NakahiraLab/dokoten/README.md

# どこ点シューズ

中平研2025卒メンバーのプロジェクトです。

## ディレクトリ構成
```
.
├── docs・・・・・・・・・・・・最終発表資料・予稿、その他学会資料など
├── shoes
|   ├── ESP32・・・・・・・・・シューズ内のESP32の制御コード
|   └── hw_model・・・・・・・シューズの設計ファイル(stl)
├── walk_test・・・・・・・・・模擬歩行実験装置を使うためのファイル群
└── README.md・・・・・・・・・このファイル
```
