NakahiraLab/dokoten/shoes/ESP32/README.md

# ESP32 動作コード

- parallelProcess
  - 並列処理コード
  - FreeRTOSを参考に自作したやつ
- simple
  - 単純な順次処理コード。動作確認に。

## 動作環境
| | |
| :-: | --- |
| マイコン | ESP32 |
| IDE | Arduino IDE 1.8.19 |
