NakahiraLab/dokoten/docs/SattoShinzato/presentation.pdf

# 増速歯車機構を用いた足押し発電試作 装置の発電量の評価

情報通信システム工学科 Ic201223 新里察得
指導教員：中平勝也

## 【視覚障害者向け歩行支援シューズ】

# 研究背景

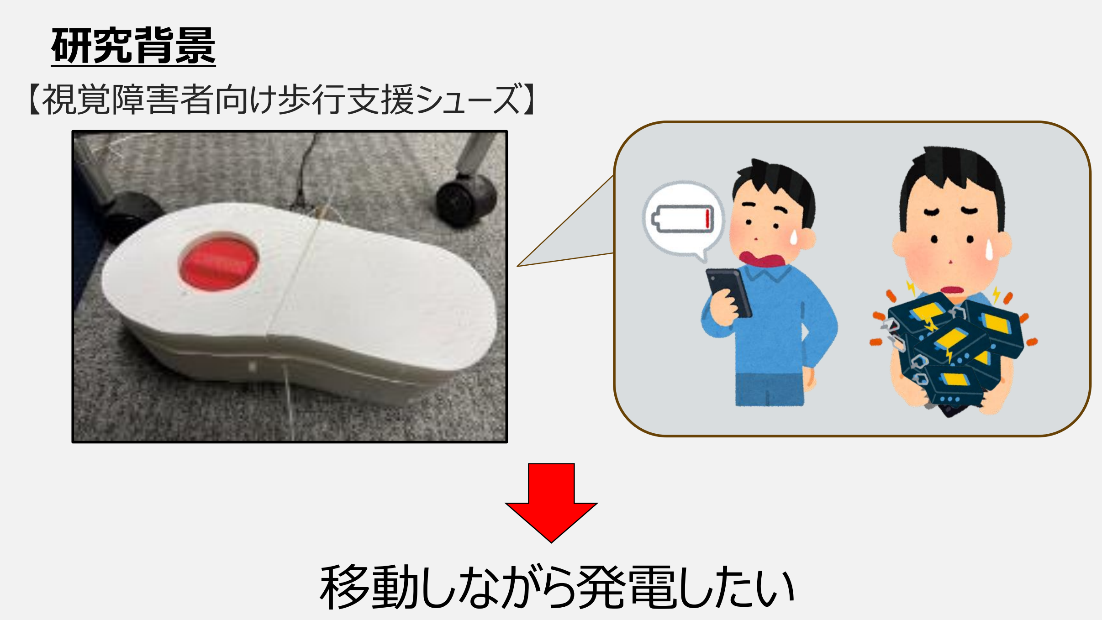
[picture p1: page 2]

# 移動しながら発電したい

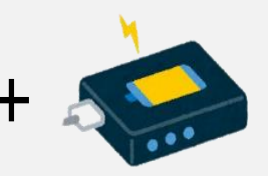
[picture p2: figure]
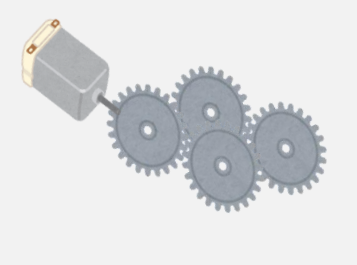
[picture p3: figure]
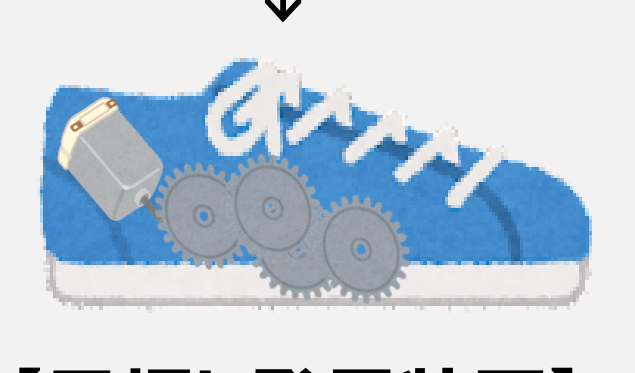
[picture p4: figure]

# 【足押し発電装置】

←

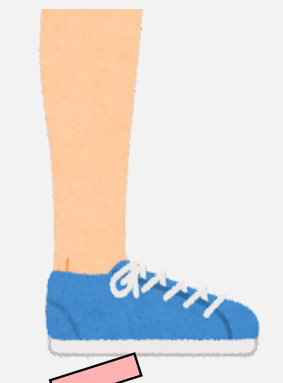
[picture p5: figure]

# 【足踏み機構】 【増速歯車装置】 【モバイルバッテリー】

# 提案する足押し発電装置

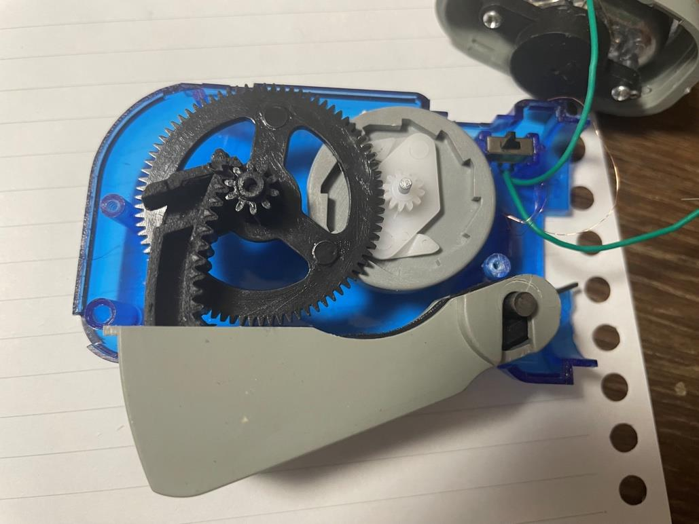
[picture p6: figure]
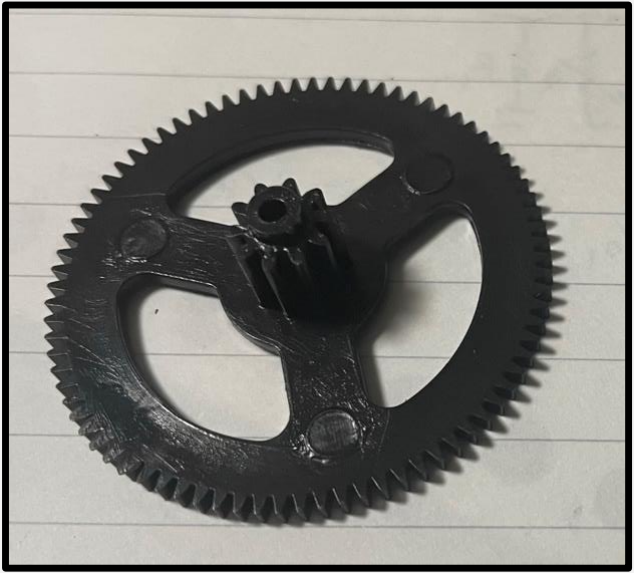
[picture p7: figure]
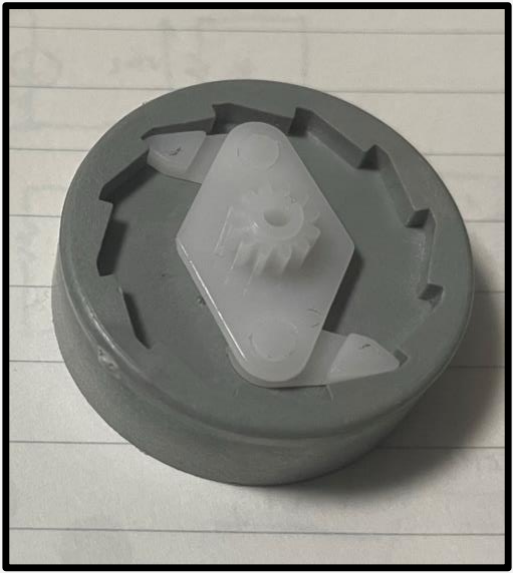
[picture p8: figure]

# 1分間に665回転することができる。

## ・直径[0.8cm] ・歯の数[12]

## 【歯車A】

## 駆動歯車

## 【歯車B】

## 発電用モーター

## ・直径[4cm]

ハンドクランクライト | ・歯の数[84]

# 増速歯車装置の内部構造

７倍

# 目標時間

# 3.8mW × 665 × 60=150Wh=150,000mWh

# 適用可能

## 【10,000mAh×3.7v】

一般的なバッテリー容量 | 消費電力
| 5,000mWh + 15,000mWh
÷ 【マイコン】 | 【スマホ】

5

# 足押し発電装置の適用判断

# 予測時間

# =1時間50分

# モバイルバッテリーを約15分で満充電

# 従来のウェアラブル発電装置

# 移動しながら発電する方法として、

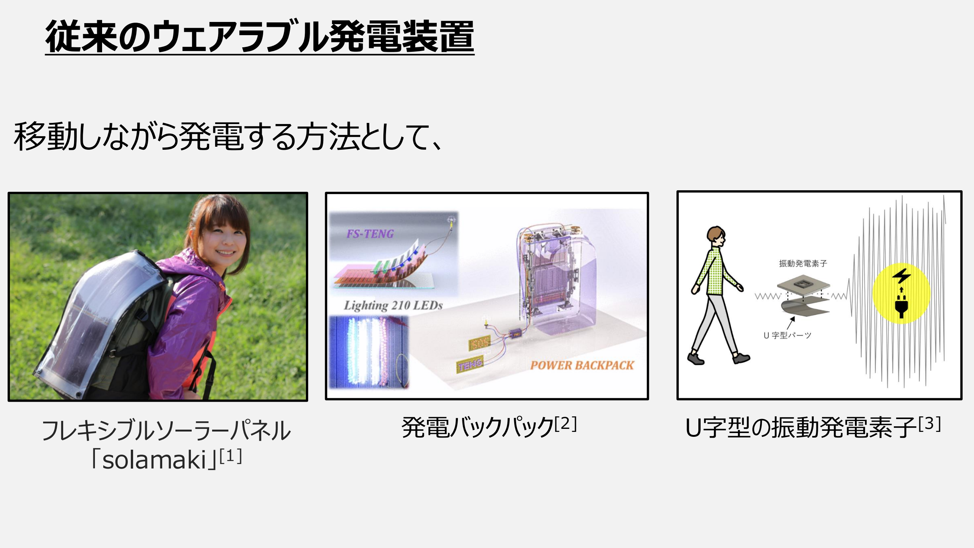
[picture p9: page 6]

## フレキシブルソーラーパネル 「solamaki」

[1]

発電バックパック[2] | U字型の振動発電素子[3]

発電方法 | ソーラーパネル | U字型圧電素子 | バック型発電機 | 足押し発電装置

# 従来のウェアラブル発電装置との定性比較

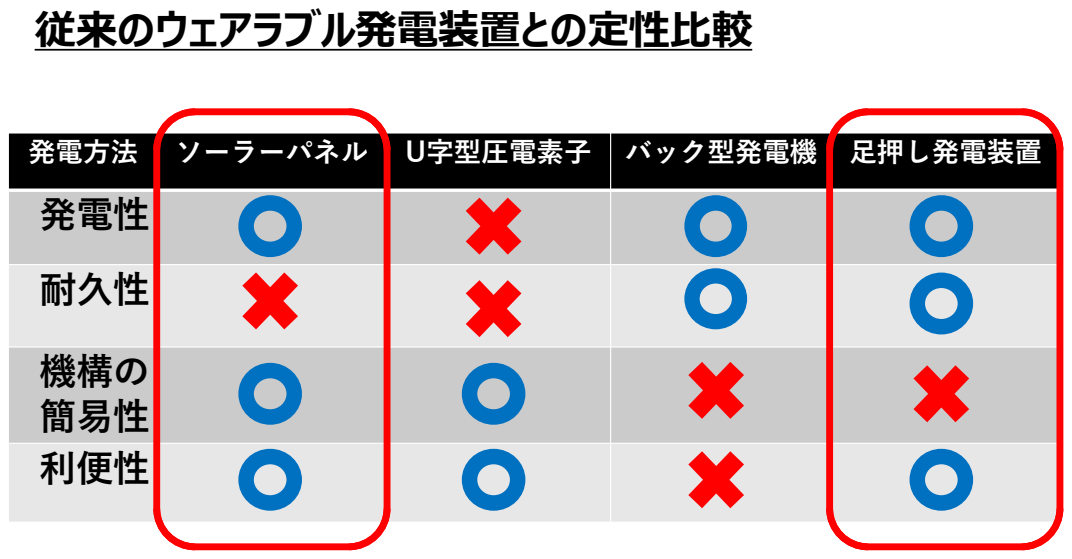
[picture p10: page 7]

発電性

耐久性

機構の 簡易性

利便性

# ソーラーパネルの発電量

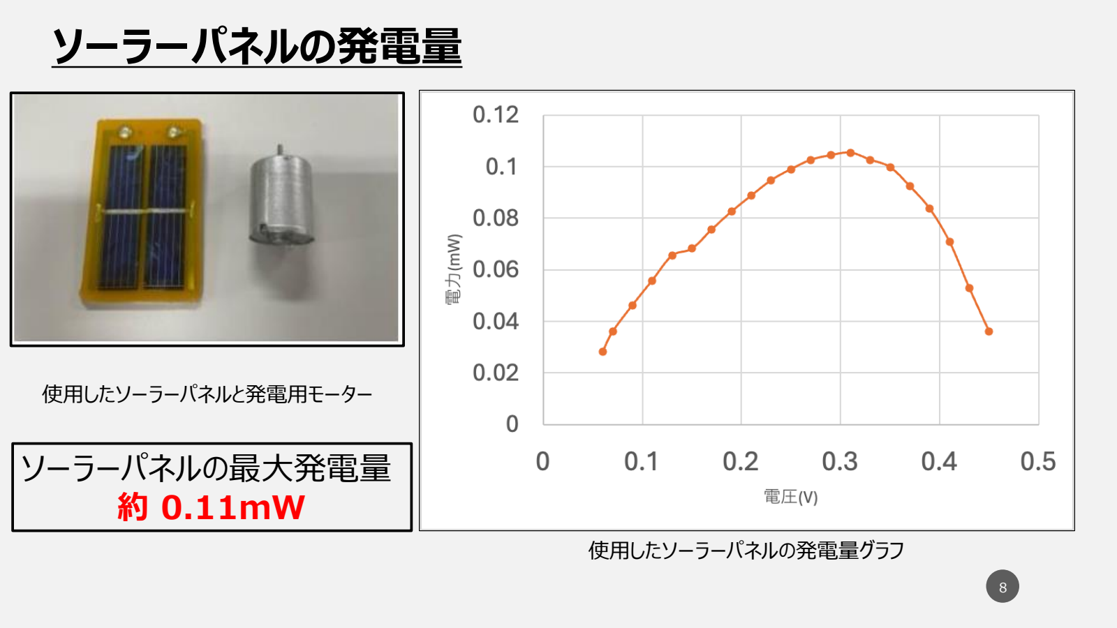
[picture p11: page 8]

8

使用したソーラーパネルと発電用モーター

使用したソーラーパネルの発電量グラフ

## ソーラーパネルの最大発電量 約 0.11mW

# ソーラーパネルの問題点

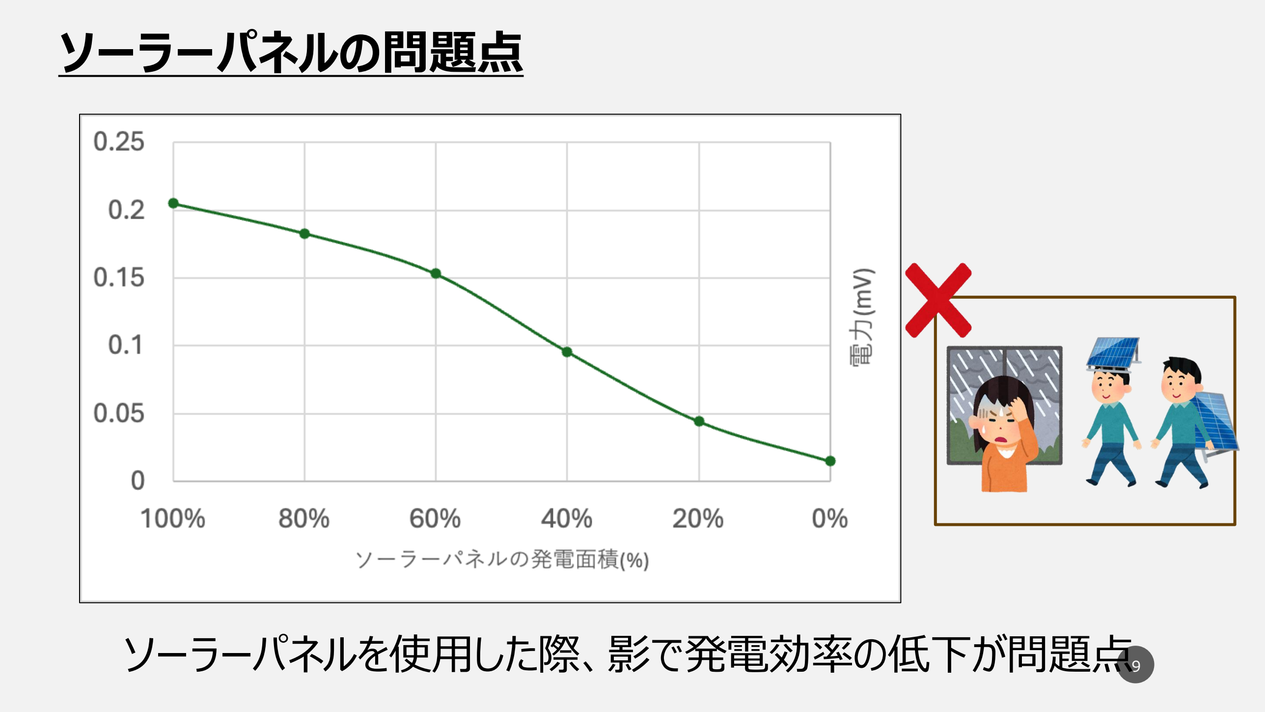
[picture p12: page 9]

9

# ソーラーパネルを使用した際、影で発電効率の低下が問題点

# 足押し発電装置の発電量計測内容

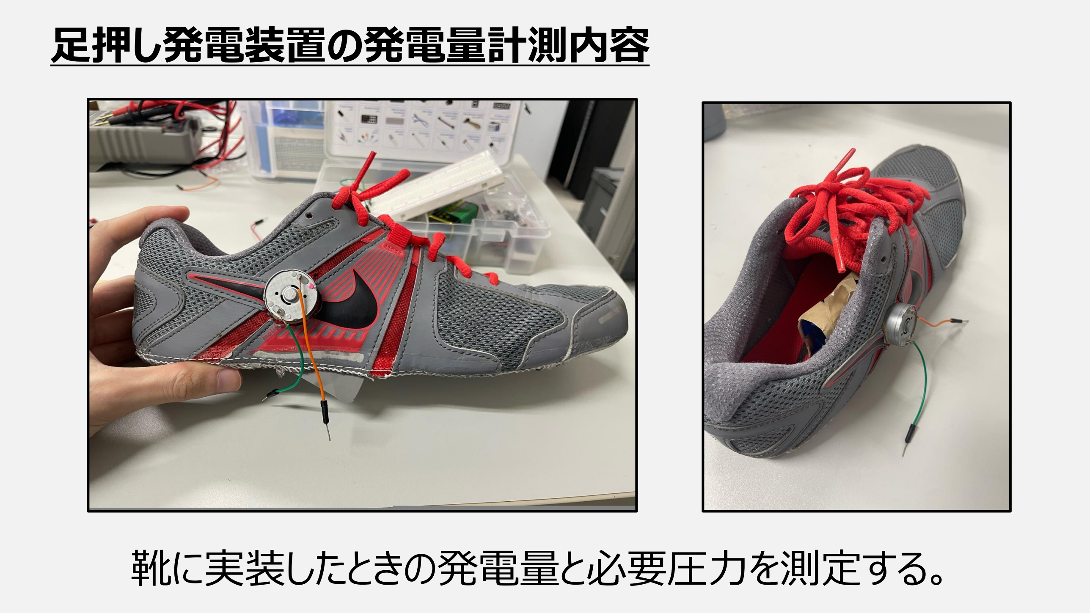
[picture p13: page 10]

# 靴に実装したときの発電量と必要圧力を測定する。

# 足押し発電装置の計測結果

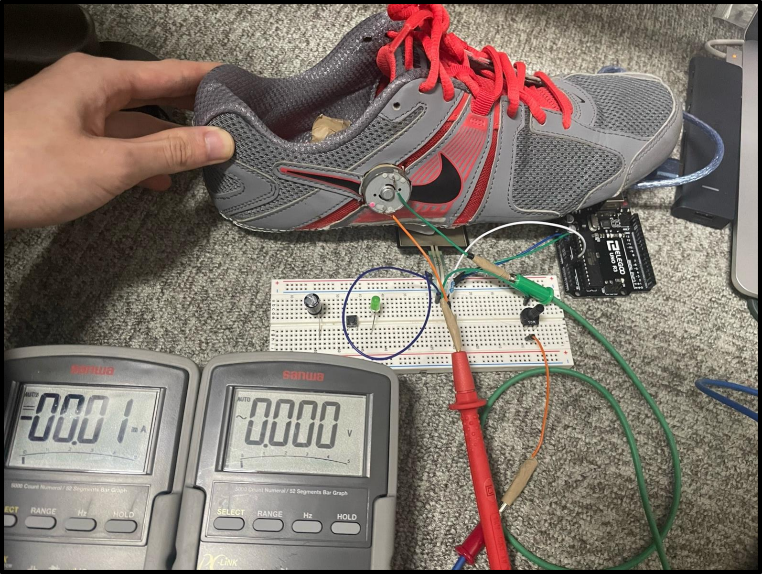
[picture p14: figure]

# 踵にかかっている圧力 約 1018Pa

# 【最大値】

発電量 | 約 2.13mW
圧力 | 約 850Pa

# 【最小値】

発電量 | 約 1.47mW
圧力 | 約 320Pa

# ソーラーパネルとの比較結果

# 【ソーラーパネルの最大発電量】 【足押し発電装置の最大発電量】

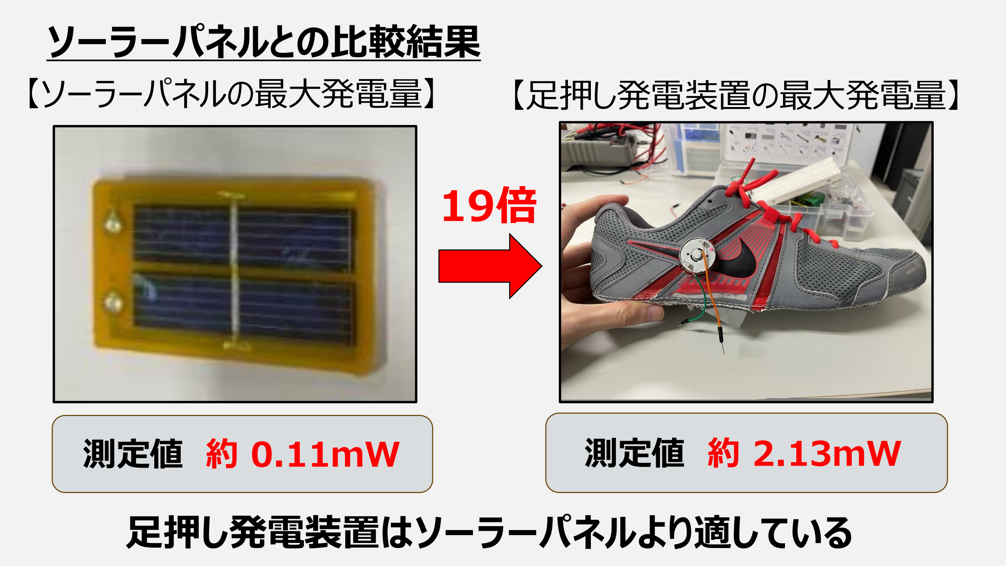
[picture p15: page 12]

# 測定値 約 2.13mW

# 足押し発電装置はソーラーパネルより適している

# 測定値 約 0.11mW

19倍

# 足押し発電装置の予測値・測定値の結果と考察

# 目標時間1時間50分を達成可能

# 予測値 約 3.80mW

# 測定値 約 2.13mW

↓44%減少

# 予測値 約 15分

# 測定値 約 26分

【最大発電量】 | 【満充電にかかる時間】

[1] みんな電力株式会社：「環境への取り組みをエンジンとした経済成長に向けて」，環境成長エンジン研究会,平成 27年7月.p72-76.
[2] Ze Yang,Yiyong Yang,Fan Liu,Zhaozheng Wang,Yindo Li,Jiahao Qiu,Xuan Xiao,Zhiwei Li,Yijia Lu,Linhong Ji,Zhong LinWang,and Jia Cheng:「Power Backpack for Energy Harvesting and Reduced Load Impact」, ACS Nano 2021, 15, 2, 2611–2623.
[3] Sengsavang Aphayvong, Shuichi Murakami, Kensuke Kanda, Norifumi Fujimura, Takeshi Yoshimura:「Enhanced Performance on Piezoelectric MEMS Vibration Energy Harvester by Dynamic Magnifier under Impulsive Force」, Applied Physics Letters,2022年10月26日.

# 参考文献
