NakahiraLab/dokoten/docs/README.md

# 発表資料 / 予稿集

- preprint: 予稿
- presentation: 発表スライド
- conference: 学会資料
- その他タイトル: 補足資料

## 学生-テーマ対応表
| | |
| :-: | --- |
| Ryoga Washizawa | 視覚障害者向け支援シューズ点字ブロック伝達機構の並列動作による時間短縮効果 |
| Satto Shinzato | 増速歯車機構を用いた足押し発電試作装置の発電量の評価 |
| Kazuki Aishima | α/β脳波比による歩行支援シューズ利用者の安心評価実験とその解析結果 |
