NakahiraLab/dokoten/docs/SattoShinzato/preprint.pdf

令和６年度卒業研究報告書

## 増速歯車機構を用いた足押し発電試作装置の発電量の評価

### 情報通信システム工学科 201223 新里察得 指導教員：中平勝也

１．はじめに
我々は、視覚障害者向け歩行支援シューズの開発をおこ
なっている。シューズには電力による点字ブロック動作機 構が組み込まれており、モバイルバッテリーのみでは 1 日 6 時間の連続動作が困難である。そこで、本研究では移動し ながらモバイルバッテリーに充電・給電する方法として足 押し発電装置の提案と試作品の評価をおこなったので報告 する。
２．提案する足押し発電装置
図１のように、足押し発電装置では、増速歯車と発電用モ ーターを靴の側面に実装し自家発電を行う。手押し発電機 に用いられる増速歯車と発電用モーターを利用し、手押し 部分を足で押す機構へと変更した。データシート上では発 電用モーターの 1 回転あたりの平均発電量は約 3.8mW であ る。成人男性が 1 分間に約 95 歩を歩くとし、増速歯車の装 置を利用して駆動歯車との速度比を 1:7 とした場合、1 時 間に約 150,000mWh の充電が可能である。この場合、 10,000mAh のモバイルバッテリーを約 25 分で満充電とする ことが可能である。

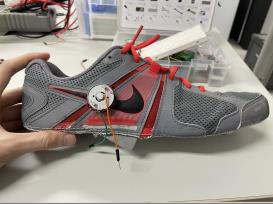
[picture p25: figure]

図１ 発電構造と給電方法
３．従来のウェアラブル発電装置との定性比較
移動しながら発電する従来装置として、みんな電力株式会 社 が 発 売 し て い る フ レ キ シ ブ ル ソ ー ラ ー パ ネ ル の 「solamaki」[1]、中国の清華大学の研究チームが開発した 「発電バックパック」[2]、U 字型の振動増幅パーツを取り付 けた小型の「振動発電素子」[3]がある。
従来装置と提案する足押し発電装置を定性的に比較した
結果を表１に示す。足押し発電装置はソーラーパネル以外 の従来よりも優れている。そこで、次節以降では、とソーラ ーパネルと足押し発電装置の定量比較を行う。
表 1 発電方式の定性的評価

表１ 従来研究との定性比較表
４．ソーラーパネルの発電量
靴に設置できる大きさのソーラーパネル[１V250mA]と発 電用モーター[1000 回転/分/7V]を使用し発電量を計測した。 その結果、ソーラーパネルの発電量は図２のとなり、最大発 電量が 0.11mW となった。

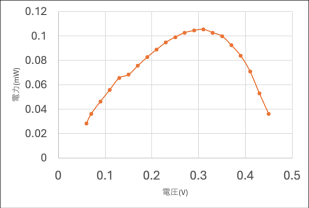
[picture p26: figure]
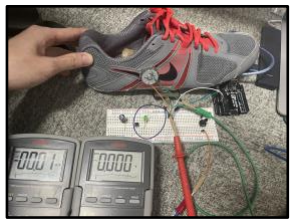
[picture p27: figure]

図２ ソーラーパネルの発電量 図３ 実証実験の様子
５．足押し発電装置の発電量
図 3 のように靴の側面とソールに足押し発電装置を搭載 し、本装置を動作させる時に押す力を変えながら、発電量を 測定した。押す力は感圧センサーで測定した。以下に測定結 果を示す。
(1)最小発電量 1.47mW、圧力 320Pa
(2)最大発電量 2.13mW、圧力 850Pa
日常生活において、かかとにかかる平均圧力は 1018Pa で ある。よって、日常生活で最大発電量である 2.13mW を得る ことできる。なお、最大発電量は 2 章で示したデータシー トの値と比較して 44％減少したが、ソーラーパネルと比較 して 19 倍となった。さらに、増速歯車装置を利用すること で、１時間に約 84,000mAh の発電が可能である。この結果、 10,000mAh のモバイルバッテリーを約 44 分で満充電できる 計算となる。
以上より、歩行支援シューズへの利用においては、足押し 発電装置はソーラーパネルより適しており、十分な発電量 を有している。なお、開発した足押し発電装置の発電量がデ ータシートのそれより減少した理由は、歯車が戻り切る前 に次の押し込みが発生するためである。卒業論文までに、内 部構造の改良を行いこの問題を解決する。
参考文献
[1] みんな電力株式会社：「環境への取り組みをエンジンとした経 済成長に向けて」，環境成長エンジン研究会,平成 27 年 7 月.p72-
[2] ZeYang,Yiyong,Yang,FanLiu,ZhaozhengWang,YindoLi,Jiahao
Qiu,Xuan | Xiao,Zhiwei | Li,Yijia | Lu,Linhong | Ji,Zhong
LinWang,and Jia Cheng:「Power Backpack for Energy Harvesting and Reduced Load Impact」, ACS Nano 2021, 15, 2, 2611–2623.
[3] SengsavangAphayvong, Shuichi Murakami, Kensuke Kanda, Norifumi Fujimura,Takeshi Yoshimura:「Enhanced Performance on Piezoelectric MEMS Vibration Energy Harvester by Dynamic
Magnifier | under | Impulsive | Force 」 , | Applied | Physics
Letters,2022 年 10 月 26 日.

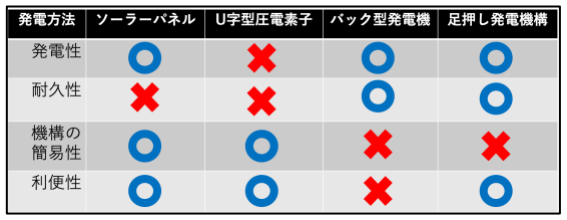
[picture p28: figure]
