NakahiraLab/dokoten/docs/RyogaWashizawa/preprint.pdf

## 令和６年度卒業研究報告書

# 視覚障害者向け支援シューズ点字ブロック伝達機構の

# 並列動作による時間短縮効果

## 情報通信システム工学科・201243・鷲澤稜河 指導教員：中平勝也

## １. はじめに

全国の道路約 130 万 km のうち、完全なバリアフリー道路は 0.1% のみである。視覚障害者へのヒヤリング調査を行なった結果、点字 ブロックがないと自由な歩行が難しいことがわかった。そこで我々 は、点字ブロックが敷設されていない道路でも視覚障害者が安全に 歩行できる支援シューズを開発している。
支援シューズを安心して利用するには、場所の状況に応じた迅 速な点字ブロック機構の反応が最重要である。そこで、本稿では、 歩行領域の認識結果に応じて、点字ブロック機構が動作する時間を 短縮する研究開発の結果を報告する。

## ２. 支援シューズの仕組み

図 1 のような視覚障害者向けの支援シューズを開発した。視覚 障害者が安全に移動できる領域を画像認識 AI で判定し、判定した 結果を靴底の点字ブロック機構で視覚障害者に的確に伝える。この ため、モータで昇降及び回転させた擬似点字ブロック（図中の赤い 部分）を利用者の足裏に押し当て、歩行可否を伝える。

図 1 視覚障害者向け支援シューズ

## ３. 動作基準時間の決定

点字ブロック機構の動作時間は利用者の安全と満足度に直結す る。そこで、図 2 に示すように、ディスプレイと支援シューズを組 み合わせた模擬歩行実験装置を作成した。ディスプレイに風景映像 が流れ、それに応じてシューズの点字ブロック機構が動作する。

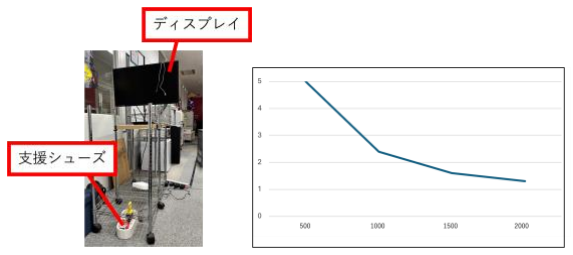
[picture p29: figure]

図 2 模擬歩行実験装置 図 3 アンケート結果
この装置を用い、利用者が求める点字ブロック機構の動作タイミン グを被験者 10 人に対してアンケート集計した。歩行可否が判断で きた後に、少し遅れて(500ms、1000ms、1500ms、2000ms)点字ブロ ック機構を動作させ、満足度を 5 段階で評価した。図 3 に示すよう に、利用者の満足度は 500ms が最も高くなった。

## ４. ハードウェア間の動作時間の測定

支援シューズのシステム構成を図 3 に示す。各ハードウェア間 の動作時間を計測した結果を表 1 に示す。カメラとシューズ間の 通信時間が 304ms と短いのに対し、点字ブロック機構の動作時間が 1490ms と非常に長い。この理由は、昇降と回転の動作がシリアル で行われているためである。

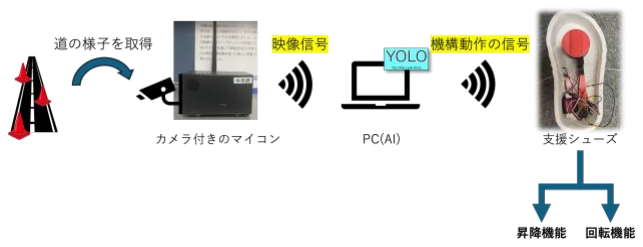
[picture p30: figure]

図 3 支援シューズのシステム構成図

表 1 順次処理における通信・動作時間

## ５. 動作処理の短縮

昇降と回転の動作をパラレル化[1]することで、点字ブロック機 構の動作時間の短縮を行う。このため、制御プログラムを書き換え た。図 4 に書き換え前後のフローチャートを示す。その結果、表 2 に示すように、点字ブロック機構の動作時間が 584ms に短縮され た。

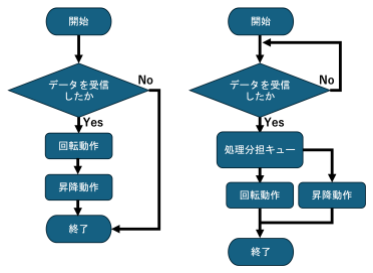
[picture p31: figure]

図 4 シリアル処理(左)とパラレル処理(右)のフローチャート 表 2 並列処理における動作時間

## ６. 満足度の評価と今後の取り組み

現在の シス テム全 体の 動作 時間は 584(カ メラ- シュ ーズ 間)+304(点字ブロック機構)=888ms である。この場合、図 3 より、 現状では半分程度の満足度が得られる。また、80%程度の満足度を 得るためには、全体の動作時間を 600ms に短縮する必要がある。 そこで今後は、カメラ-シューズ間の時間と点字ブロック機構の 動作時間をそれぞれ 30%削減することを目指す。前者は主に AI 画 像処理の時間を減らす。後者は主に点字ブロック機構のモータ部分 にかかる摩擦を減らす。後者は卒業論文の提出までに完了する。

参考文献
[1] 谷本和俊、「Amazon FreeRTOS を ESP32-DevKitC に書き込む」、 コンピュータ・サイエンス&テクノロジ専門誌、p.47-50、2022
