NakahiraLab/dokoten/docs/RyogaWashizawa/presentation.pdf

# 視覚障害者向け支援シューズ点字ブロック伝達機構の 並列動作による時間短縮効果

## 情報通信システム工学科・201243・鷲澤稜河 指導教員：中平勝也

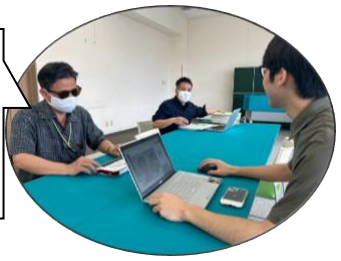
[picture p32: figure]

## シューズ型のデバイスで歩行支援

## 場所の状況に応じた迅速な 動作が最重要

点字が無い場所では
うまく歩けない

## 視覚障害者 歩行支援の背景

全国の道路の長さ(km) | バリアフリー道路(km)
1,283,725 | 2,294

## 視覚障がい者は自由な歩行が難しく、

## サポートされている道路が少ない

## 視覚障害者向け支援シューズ

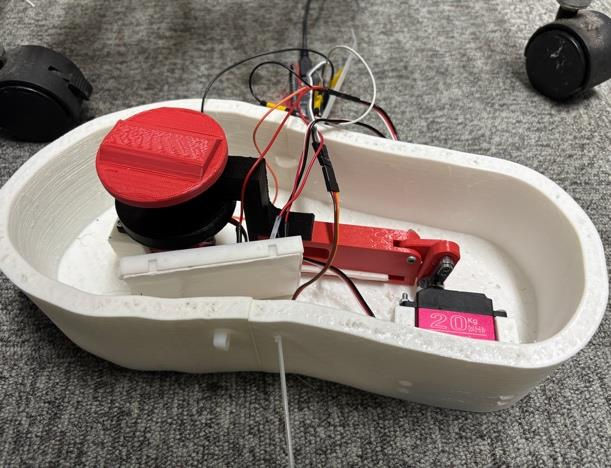
[picture p33: figure]
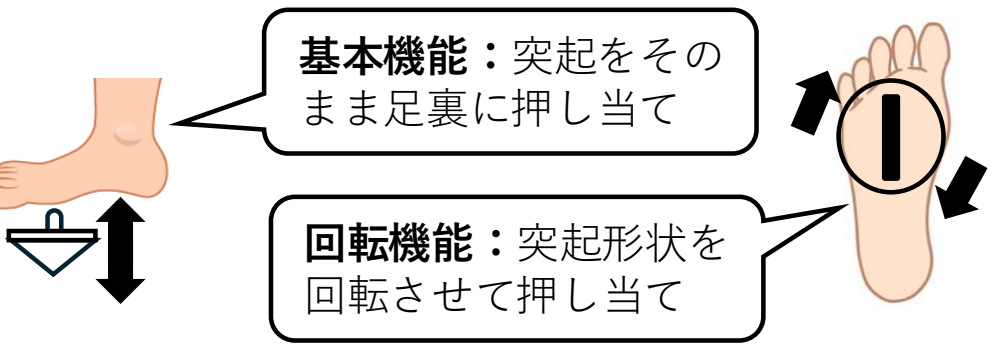
[picture p34: figure]
基本機能：突起をその まま足裏に押し当て; 回転機能：突起形状を 回転させて押し当て

誘導(線状)ブロックを
模倣したもの

「安全」を伝える機構

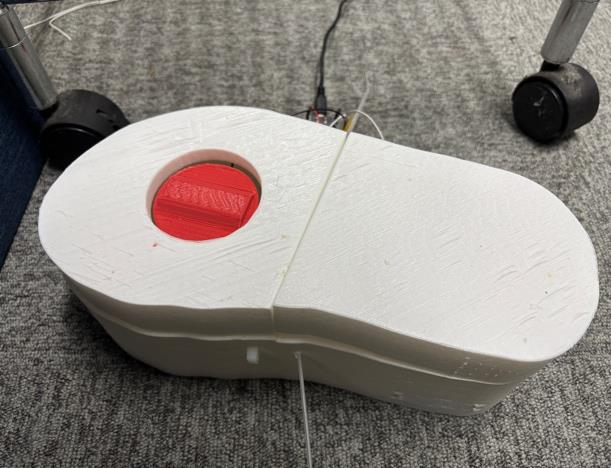
[picture p35: figure]
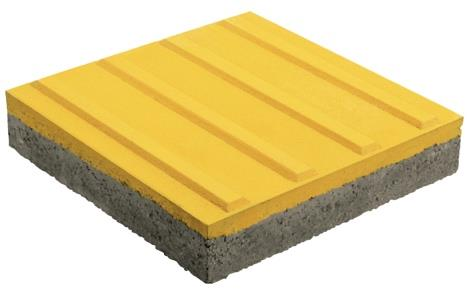
[picture p36: figure]

このブロックを足裏に押し付ける

モータを用い、ブロックを押し出して上下に動作

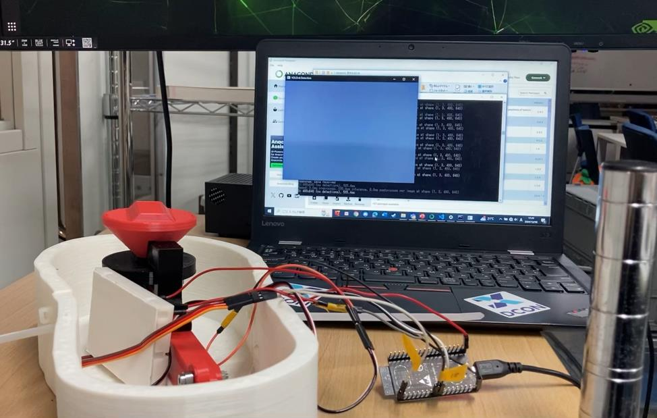
[picture p37: figure]

安全/危険を伝える基本機能と、進むべき方向
を伝える回転機能がある。

【点字ブロック伝達機構】

【2種類の機能】
=

試作モデルの開発

## 全体像

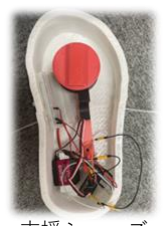
[picture p38: figure]
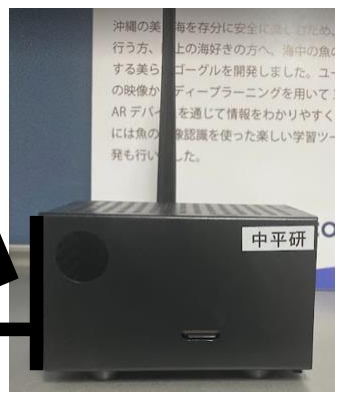
[picture p39: figure]
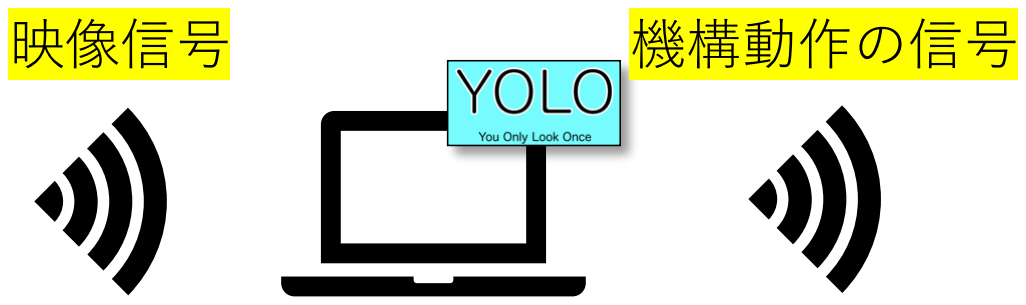
[picture p40: figure]
映像信号; 機構動作の信号

道の様子を取得

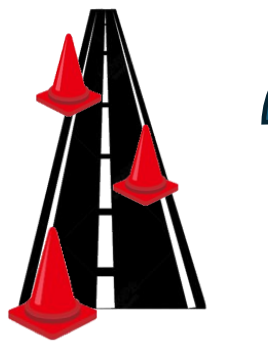
[picture p41: figure]
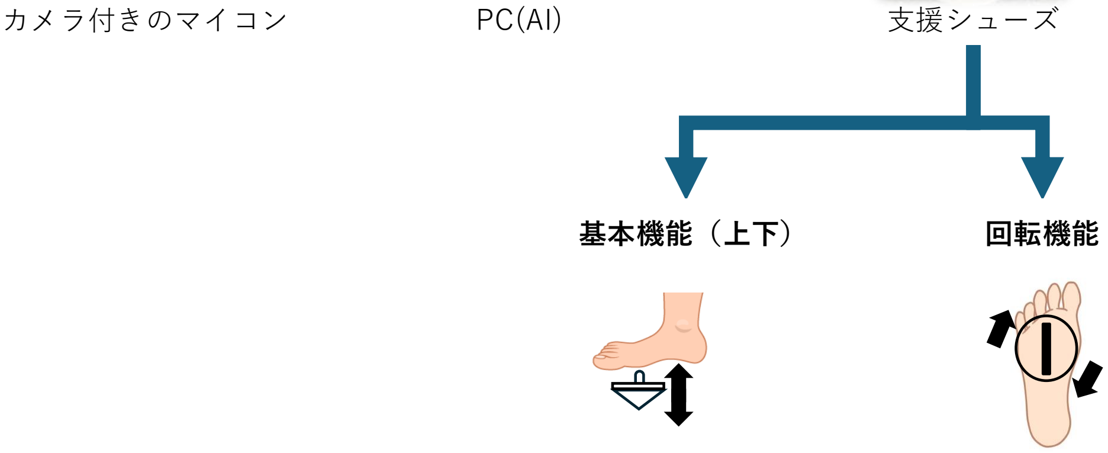
[picture p42: figure]
カメラ付きのマイコン; 支援シューズ; 基本機能（上下）; 回転機能

## 中平研 他メンバーの開発

セマンティックセグメンテーション方式による歩行領域の検出 Yolov8のSS方式で歩行領域の検出を行なった。

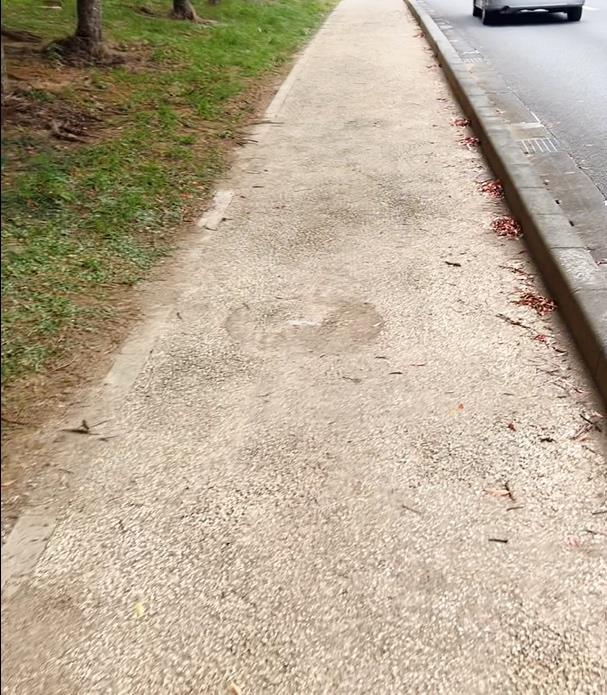
[picture p43: figure]
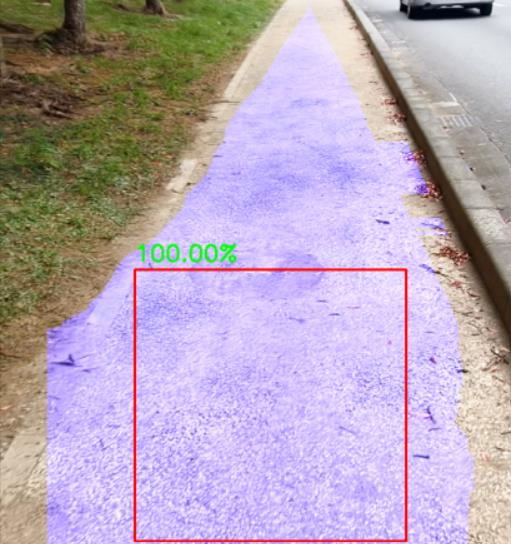
[picture p44: figure]

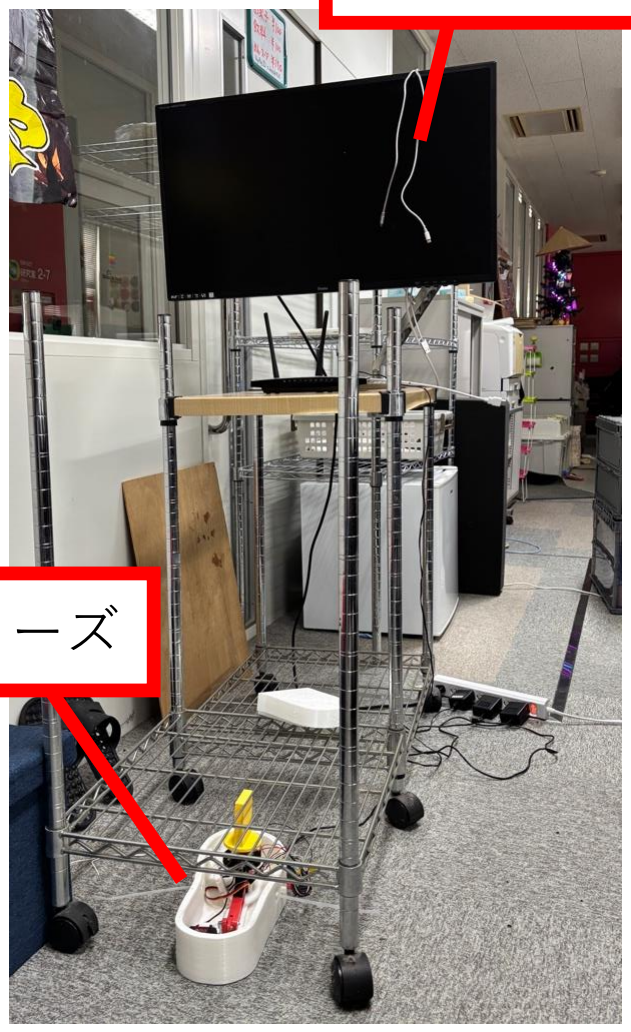
[picture p45: figure]

支援シューズ

## 動作基準時間の決定と動作時間の測定

より安全で満足度の高い歩行の検証のため、画像の装置を作成した。

ディスプレイ

## ディスプレイに風景映像が流れ、 それに応じて点字ブロック機構が動作

実験

利用者が求める点字ブロック機構の動作タイミングをアンケートで集計（10人）

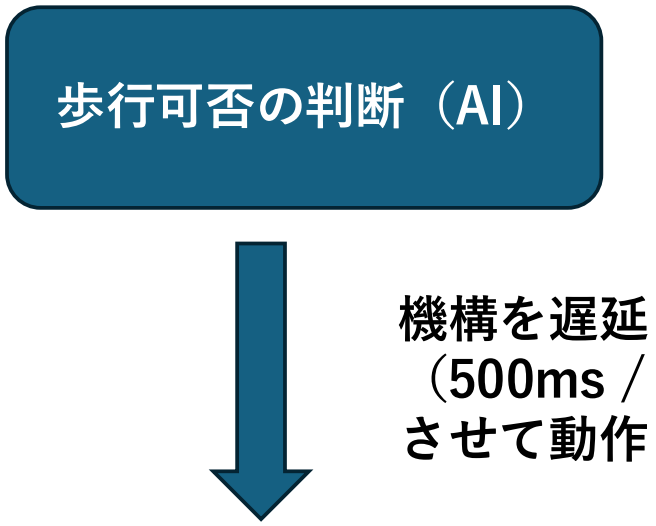
[picture p46: figure]
歩行可否の判断（AI）; 機構を遅延; させて動作

（500ms / 1000ms / 1500ms / 2000ms）

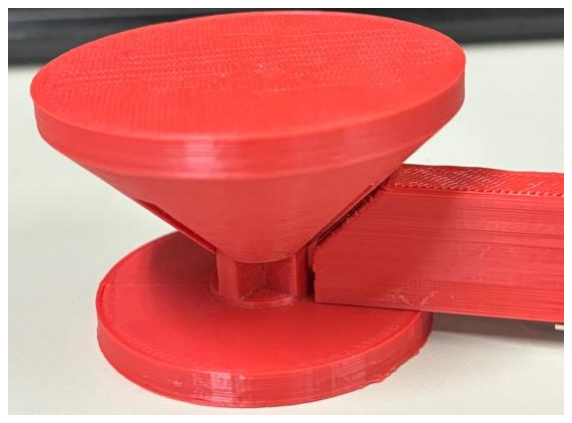
[picture p47: figure]

## 実験結果

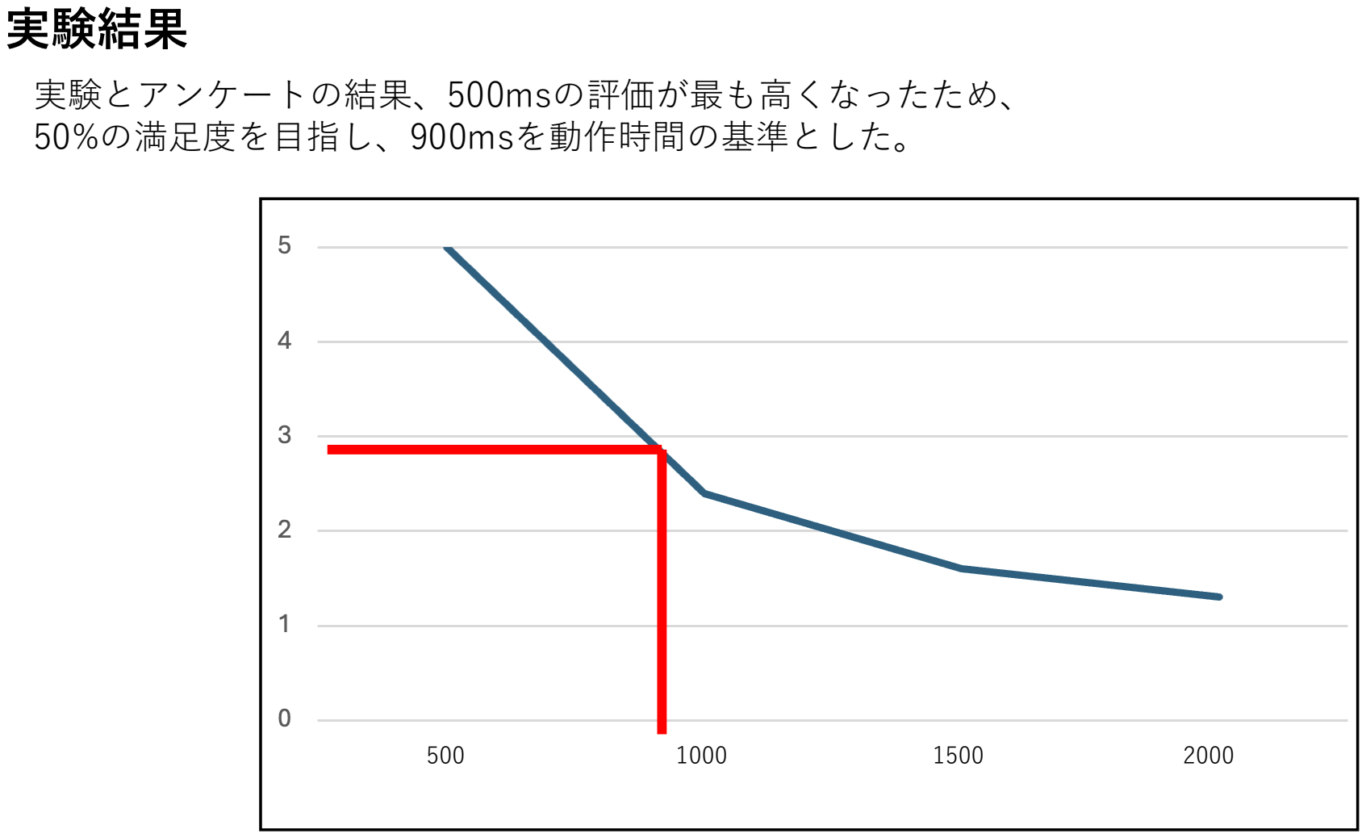
[picture p48: page 8]

実験とアンケートの結果、500msの評価が最も高くなったため、 50%の満足度を目指し、900msを動作時間の基準とした。

500 | 1000 | 1500 | 2000

カメラ付きのマイコン | PC(AI) | 支援シューズ

## シリアル処理における通信・動作時間

道の様子を取得

304ms | 1490ms （上下：806ms、回転：684ms）

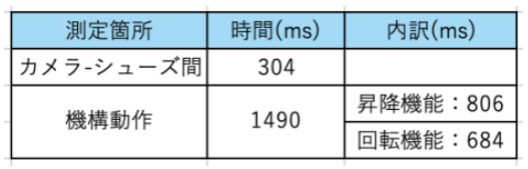
[picture p49: figure]

## 動作処理の短縮

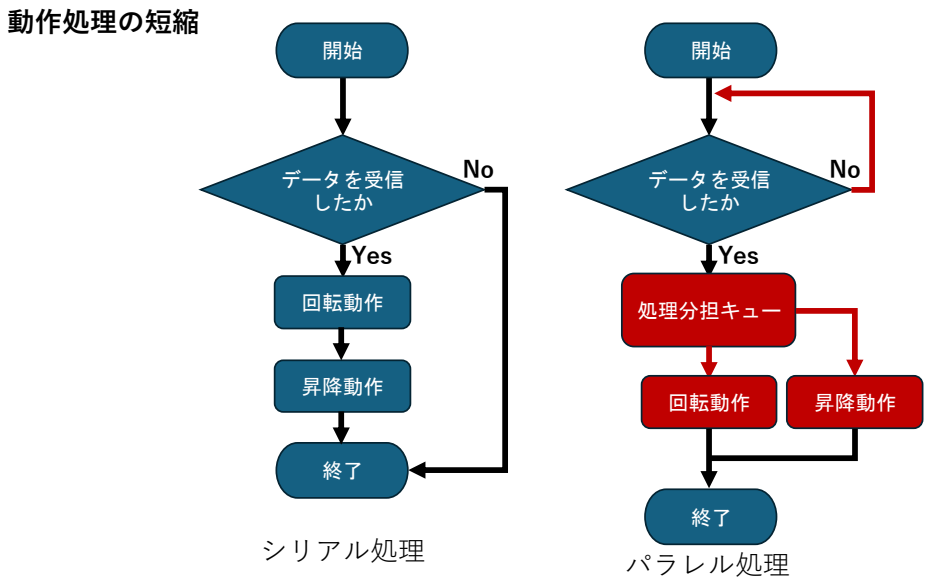
[picture p50: page 10]
データを受信 したか; Yes; 処理分担キュー; 回転動作; 昇降動作; シリアル処理; パラレル処理

カメラ付きのマイコン | PC(AI) | 支援シューズ

## パラレル処理における通信・動作時間

道の様子を取得

304ms | 584ms （上下：584ms、回転：492ms）

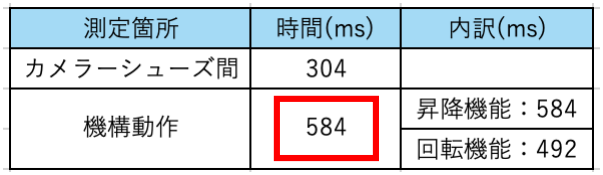
[picture p51: figure]

# 合計：884ms

## 安全・満足度向上のために

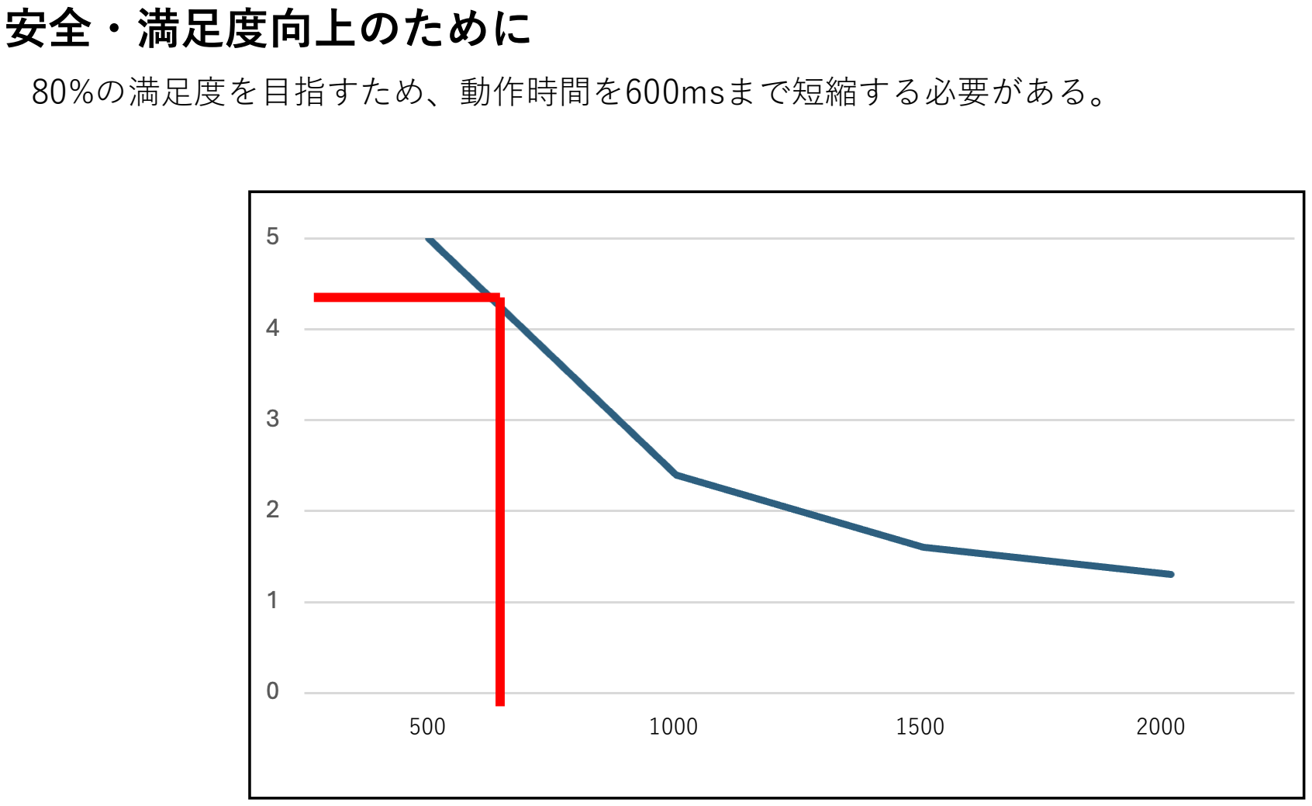
[picture p52: page 12]

500 | 1000 | 1500 | 2000

80%の満足度を目指すため、動作時間を600msまで短縮する必要がある。

カメラ付きのマイコン | PC(AI) | 支援シューズ

## 安全・満足度向上のために

道の様子を取得

304ms | 584ms
200ms | 400ms
