NakahiraLab/dokoten/shoes/hw_model/pushPrt/pushBase1.STL

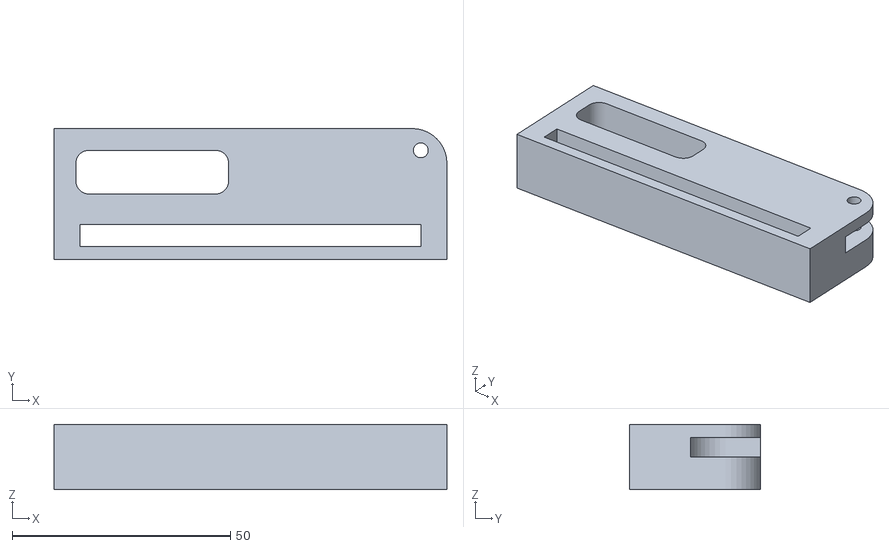
[picture p53: CAD file, 2025-02-03]
shoes/hw_model/pushPrt/pushBase1.STL
90.0 x 30.0 x 15.0
