NakahiraLab/dokoten/shoes/hw_model/shell/rearCover.STL

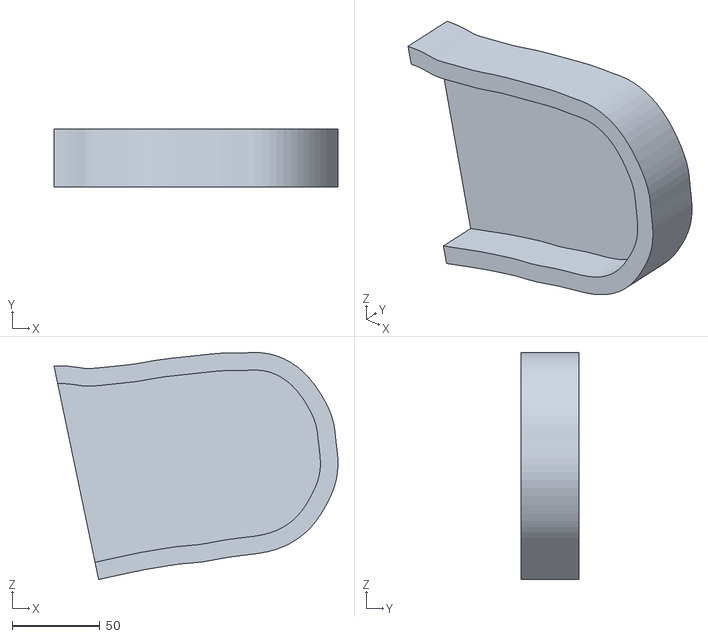
[picture p54: CAD file, 2025-02-03]
shoes/hw_model/shell/rearCover.STL
161.4 x 33.0 x 129.0
