NakahiraLab/dokoten/shoes/hw_model/table.STL

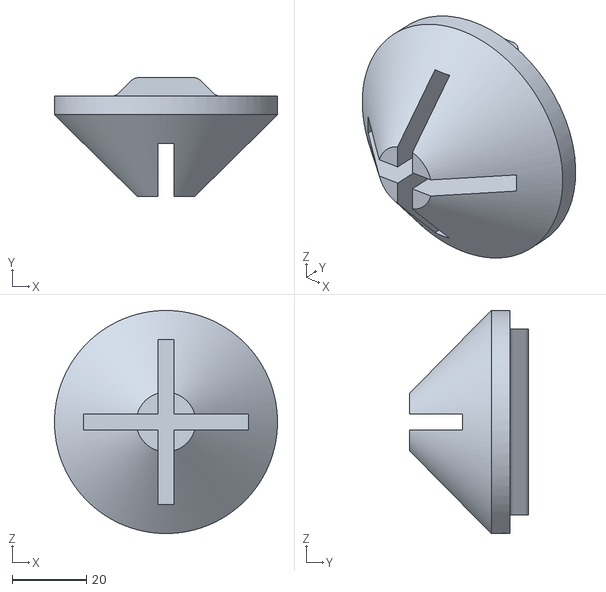
[picture p55: CAD file, 2025-02-03]
shoes/hw_model/table.STL
60.0 x 32.0 x 60.0
