NakahiraLab/dokoten/shoes/hw_model/pushPrt/pushBase2.STL

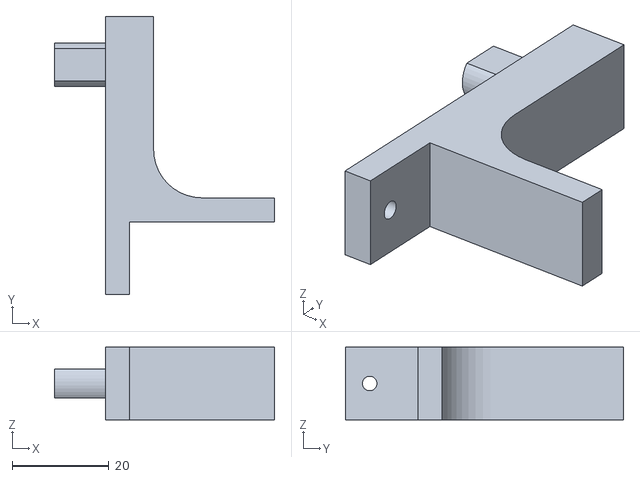
[picture p56: CAD file, 2025-02-03]
shoes/hw_model/pushPrt/pushBase2.STL
45.5 x 57.5 x 15.0
