NakahiraLab/dokoten/shoes/hw_model/shell/frontCover.STL

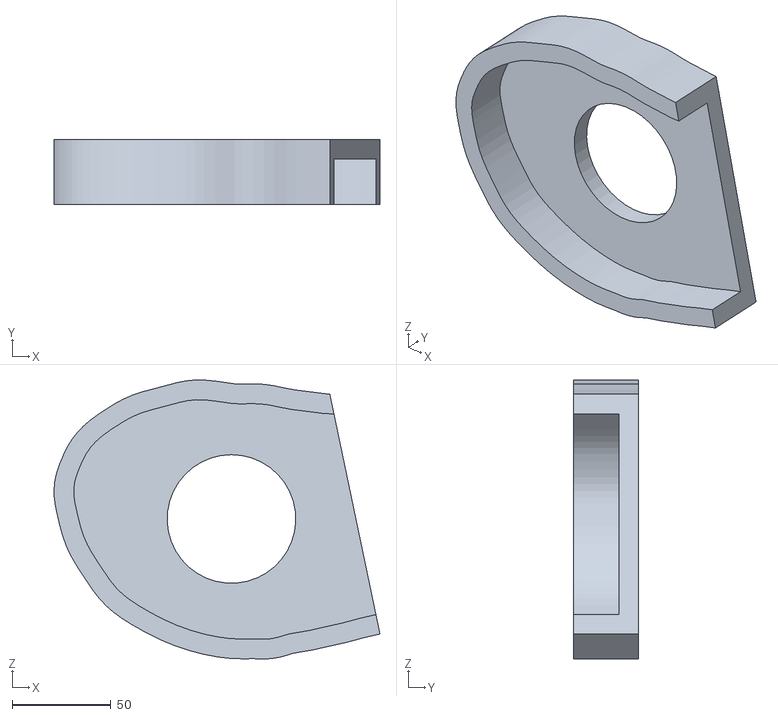
[picture p57: CAD file, 2025-02-03]
shoes/hw_model/shell/frontCover.STL
164.8 x 33.0 x 141.1
