NakahiraLab/dokoten/shoes/hw_model/pushPrt/push1.STL

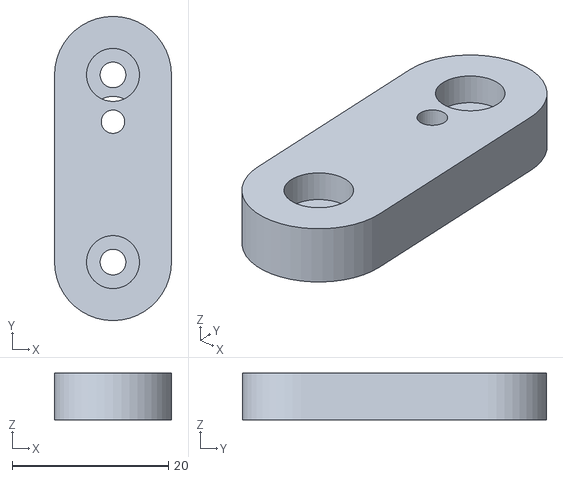
[picture p58: CAD file, 2025-02-03]
shoes/hw_model/pushPrt/push1.STL
15.0 x 39.0 x 6.00
