NakahiraLab/dokoten/shoes/hw_model/shell/fromtSole.STL

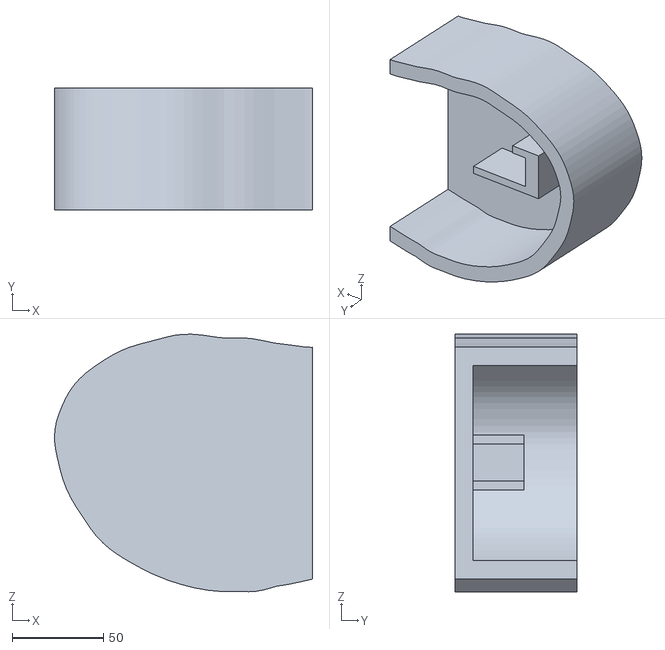
[picture p59: CAD file, 2025-02-03]
shoes/hw_model/shell/fromtSole.STL
141.3 x 67.0 x 141.0
