NakahiraLab/dokoten/shoes/hw_model/pushPrt/push2.STL

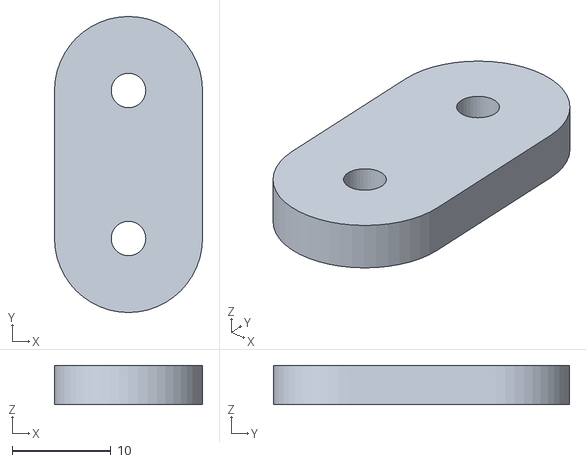
[picture p60: CAD file, 2025-02-03]
shoes/hw_model/pushPrt/push2.STL
15.0 x 30.0 x 4.00
