NakahiraLab/dokoten/shoes/hw_model/shell/rearSole.STL

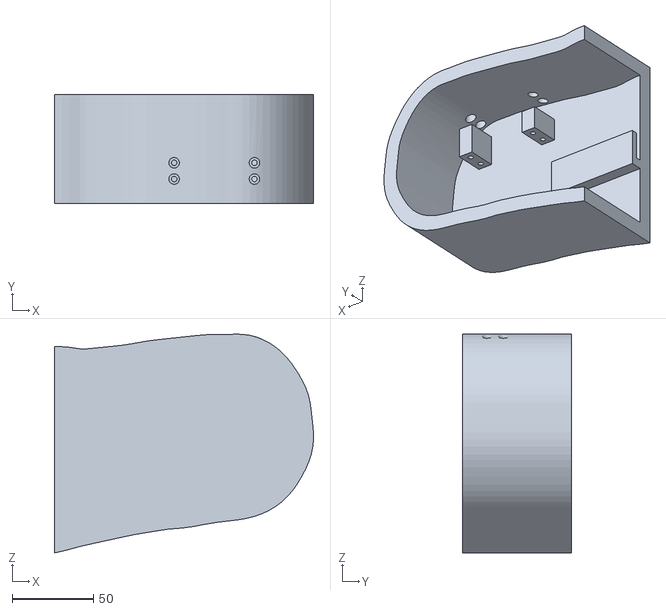
[picture p61: CAD file, 2025-02-03]
shoes/hw_model/shell/rearSole.STL
159.5 x 67.0 x 134.7
