NakahiraLab/dokoten/shoes/hw_model/pushPrt/stick.STL

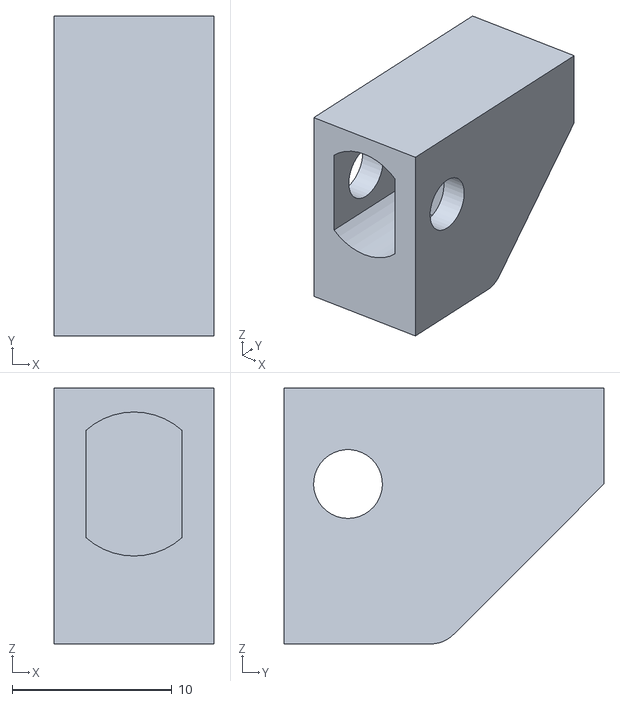
[picture p62: CAD file, 2025-02-03]
shoes/hw_model/pushPrt/stick.STL
10.0 x 20.0 x 16.0
