NakahiraLab/dokoten/walk_test/README.md

# 模擬歩行実験装置用

- ESP32_MoveTest.py
  - シンプルな上げ下げの動作をするコード
- ESP32_Test.py
  - 応答時間が見られるコード
- SideWalkTest.yaml
  - Anacondaの環境が入っているファイル

## 使い方
1. [こちらの記事](https://qiita.com/maami415/items/c0f382fd88e1d173d288)を参考に環境構築 & 仮想環境のアクティベート
2. pythonプログラムを実行
