NakahiraLab/dokoten/(commit log)

2025-02-03 add: 資料の追加
2025-02-03 add: 各種プログラムの追加
    [fromtSole.STL, frontCover.STL, push1.STL, push2.STL, pushBase1.STL, pushBase2.STL, rearCover.STL, rearSole.STL]
2025-02-14 add: 資料追加
